oxkDev/Custom-Mechanical-Keyboard/README.md

# Custom-Mechanical-Keyboard
A custom low-profile 75% mechanical keyboard using a WeAct Blackpill v3.1 (STM32F411CEU6).
