oxkDev/Custom-Mechanical-Keyboard/Custom Keyboard Exports/Custom Mechanical Keyboard.csv

Reference | Qty | Value | DNP | Exclude from BOM | Type | Manufacturer | MFG Part # | Footprint | Description
C1,C2,C3,C4,C5,C6,C7,C8,C9,C10,C11,C12 | 12 | 100nF |  |  | SMD | Murata Electronics | GRM3195C2A104JA01D | Capacitor_SMD:C_1206_3216Metric | Multilayer Ceramic Capacitors MLCC - SMD/SMT 0.1 uF 100 VDC 5% 1206 C0G (NP0)
CAPS_LED1 | 1 | SK6812MINI-E |  |  | SMD | Shenzhen Normand Electronic | SK6803MINI-E | LED_SMD:LED_SK6812MINI-E_PLCC4_3.2x2.8mm_P1.5mm_1 | 3.2x2.8x1.78 mm 0.2W Intelligent external control surface mount SMD LED (Facing away from PCB)
J1 | 1 | USB_C_Receptacle_USB2.0_16P | DNP | Excluded from BOM |  |  |  | PCM_marbastlib-various:USB_C_Receptacle_HRO_TYPE-C-31-M-14_(polygon_edge) | USB 2.0-only 16P Type-C Receptacle connector
J2 | 1 | Conn_01x04 | DNP | Excluded from BOM |  |  |  | Connector_PinHeader_2.00mm:PinHeader_1x04_P2.00mm_Vertical | Generic connector, single row, 01x04, script generated (kicad-library-utils/schlib/autogen/connector/)
J3 | 1 | Conn_01x05 |  | Excluded from BOM |  |  |  | Connector_PinHeader_2.00mm:PinHeader_1x05_P2.00mm_Vertical | Generic connector, single row, 01x05, script generated (kicad-library-utils/schlib/autogen/connector/)
J4 | 1 | Conn_01x06 |  | Excluded from BOM |  |  |  | Connector_PinHeader_2.00mm:PinHeader_1x06_P2.00mm_Vertical | Generic connector, single row, 01x06, script generated (kicad-library-utils/schlib/autogen/connector/)
J5 | 1 | Conn_01x07 |  | Excluded from BOM |  |  |  | Connector_PinHeader_2.00mm:PinHeader_1x07_P2.00mm_Vertical | Generic connector, single row, 01x07, script generated (kicad-library-utils/schlib/autogen/connector/)
J6,J7 | 2 | Conn_01x20_Socket |  |  |  |  |  | PCM_marbastlib-various:XUNPU_FPC-05F-20PH20_1x20-1MP_P0.5mm_Horizontal | Generic connectable mounting pin connector, single row, 01x20, script generated (kicad-library-utils/schlib/autogen/connector/)
LED1,LED2,LED3,LED4,LED5,LED6,LED7,LED8,LED9,LED10,LED11,LED12,LED13,LED14,LED15,LED16,LED17,LED18,LED19,LED20,LED21,LED22,LED23,LED24,LED25,LED26,LED27,LED28,LED29,LED30,LED31,LED32,LED33,LED34,LED35,LED36,LED37,LED38,LED39,LED40,LED41,LED42,LED43,LED44,LED45,LED46,LED47,LED48,LED49,LED50,LED51,LED52,LED53,LED54,LED55,LED56,LED57,LED58,LED59,LED60,LED61,LED62,LED63,LED64,LED65,LED66,LED67,LED68,LED69,LED70,LED71,LED72,LED73,LED74,LED75,LED76,LED77,LED78,LED79,LED80,LED81,LED82,LED83,LED84 | 84 | SK6812MINI-E_Rev |  |  | SMD | Shenzhen Normand Electronic | SK6803MINI-E | LED_SMD:LED_SK6812MINI-E_Reversed_PLCC4_3.2x2.8mm_P1.5mm | 3.2x2.8x1.78 mm 0.2W Intelligent external control surface mount SMD LED (Facing into PCB)
R1,R2 | 2 | 5.1k | DNP | Excluded from BOM | SMD | Panasonic | ERJ-8ENF5101V | Resistor_SMD:R_1206_3216Metric_Pad1.30x1.75mm_HandSolder | 5.1 kOhms ±1% 0.25W, 1/4W Chip Resistor 1206 (3216 Metric) Automotive AEC-Q200 Thick Film
R3,R4 | 2 | 100k |  |  | SMD | Panasonic | ERJ-U08D1003V | Resistor_SMD:R_1206_3216Metric_Pad1.30x1.75mm_HandSolder | Thick Film Resistors - SMD 1206 0.5% 100kOhm Anti-Sulfur AEC-Q200
ROT_SW1 | 1 | RotaryEncoder_Switch_MP |  | Excluded from BOM |  |  |  | Rotary_Encoder:RotaryEncoder_Alps_EC12E-Switch_Vertical_H20mm | Rotary encoder, dual channel, incremental quadrate outputs, with switch and MP Pin
SOI8_SLCT1,USB_DM1,USB_DP1,USB_ID1,USB_VBUS1,VBat1 | 6 | TestPoint |  | Excluded from BOM |  |  |  | TestPoint:TestPoint_Pad_D1.0mm | test point
SW1,SW2,SW3,SW4,SW5,SW6,SW7,SW8,SW9,SW10,SW11,SW12,SW13,SW14,SW15,SW16,SW17,SW18,SW19,SW20,SW21,SW22,SW23,SW24,SW25,SW26,SW27,SW28,SW29,SW30,SW31,SW32,SW33,SW34,SW35,SW36,SW37,SW38,SW39,SW40,SW41,SW42,SW43,SW44,SW45,SW46,SW47,SW48,SW49,SW50,SW51,SW52,SW53,SW54,SW55,SW56,SW57,SW58,SW59,SW60,SW61,SW62,SW63,SW64,SW65,SW66,SW67,SW68,SW69,SW70,SW71,SW72,SW73,SW74,SW75,SW76,SW77,SW78,SW79,SW80,SW81,SW82,SW83,SW84 | 84 | SW_SPST |  | Excluded from BOM |  |  |  | Key_Switches_Low_Profile:SW_MX_Kailh_Choc_V1V2_Mill-Max_Hybrid | Key Switch
SW85 | 1 | SW_Slide_DPDT |  |  | Thru-Hole | C&K | JS202011AQN | Button_Switch_THT:SW_CK_JS202011AQN_DPDT_Angled | SWITCH SLIDE DPDT 300MA 6V
U1 | 1 | Blackpill |  | Excluded from BOM |  |  |  | Weact_Blackpill_STM32F411CEU6:STM32F4x1CxU6 WeActStudio | MCU
U2 | 1 | TXS0101DBV |  |  | SMD | Texas Instruments | TXS0101DBV | Package_TO_SOT_SMD:SOT-23-6 | 1-Bit Bidirectional Voltage-Level Shifter for Open-Drain and Push-Pull Application, SOT-23
U3 | 1 | USBLC6-2SC6 |  |  | SMD | STMicroelectronics | USBLC6-2SC6 | Package_TO_SOT_SMD:SOT-23-6 | Very low capacitance ESD protection diode, 2 data-line, SOT-23-6
D1,D3,D5,D7,D9,D11,D13,D15,D17,D19,D21,D23,D25,D27,D29,D32,D34,D36,D38,D40,D42,D44,D45,D47,D49,D51,D53,D55,D57,D61,D63,D65,D67,D69,D71,D72,D73,D75,D77,D80,D81,D83,ROT_D1 | 43 | D |  |  | SMD | Diodes Incorporated | 1N4148W-F | Keyboard_Parts_Footprint:D_SOD123 | Small Signal Switching Diodes 400mW 100Vrrm 4ns
D2,D4,D6,D8,D10,D12,D14,D16,D18,D20,D22,D24,D26,D28,D30,D31,D33,D35,D37,D39,D41,D43,D46,D48,D50,D52,D54,D56,D58,D59,D60,D62,D64,D66,D68,D70,D74,D76,D78,D79,D82,D84 | 42 | D_Rev |  |  | SMD | Diodes Incorporated | 1N4148W-F | Keyboard_Parts_Footprint:D_SOD123_Rev | Small Signal Switching Diodes 400mW 100Vrrm 4ns
