oxkDev/Custom-Mechanical-Keyboard/Custom Keyboard Kicad/Custom Mechanical Keyboard.kicad_pcb

## KiCad design Custom Keyboard Kicad/Custom Mechanical Keyboard.kicad_pcb (2025-11-11)

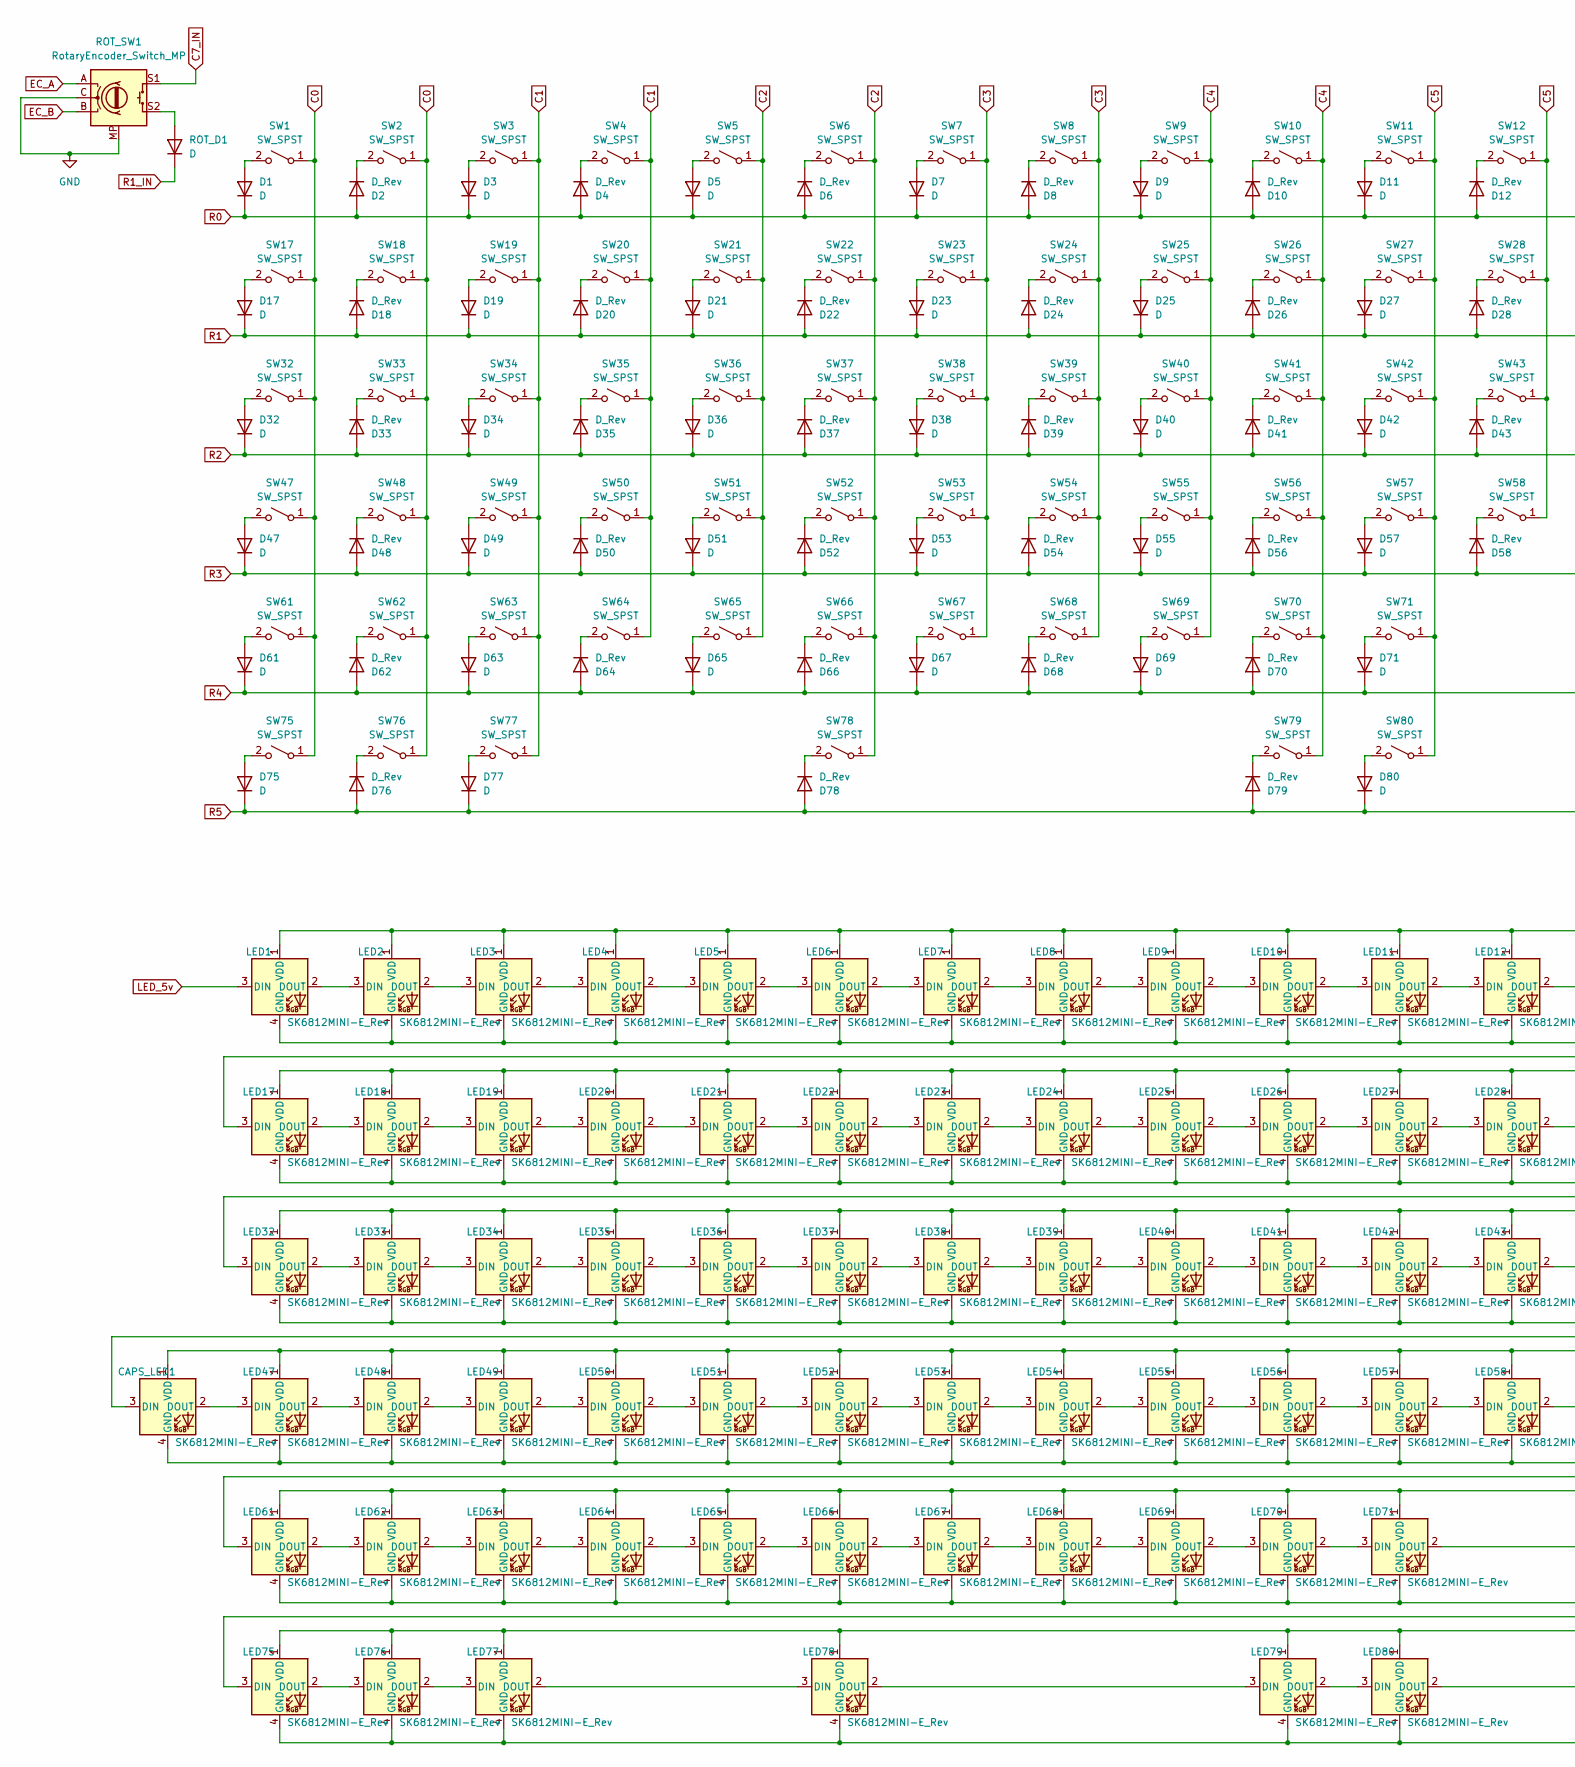
[picture p1: schematic Custom Mechanical Keyboard.kicad_sch, part in row 1, column 1]

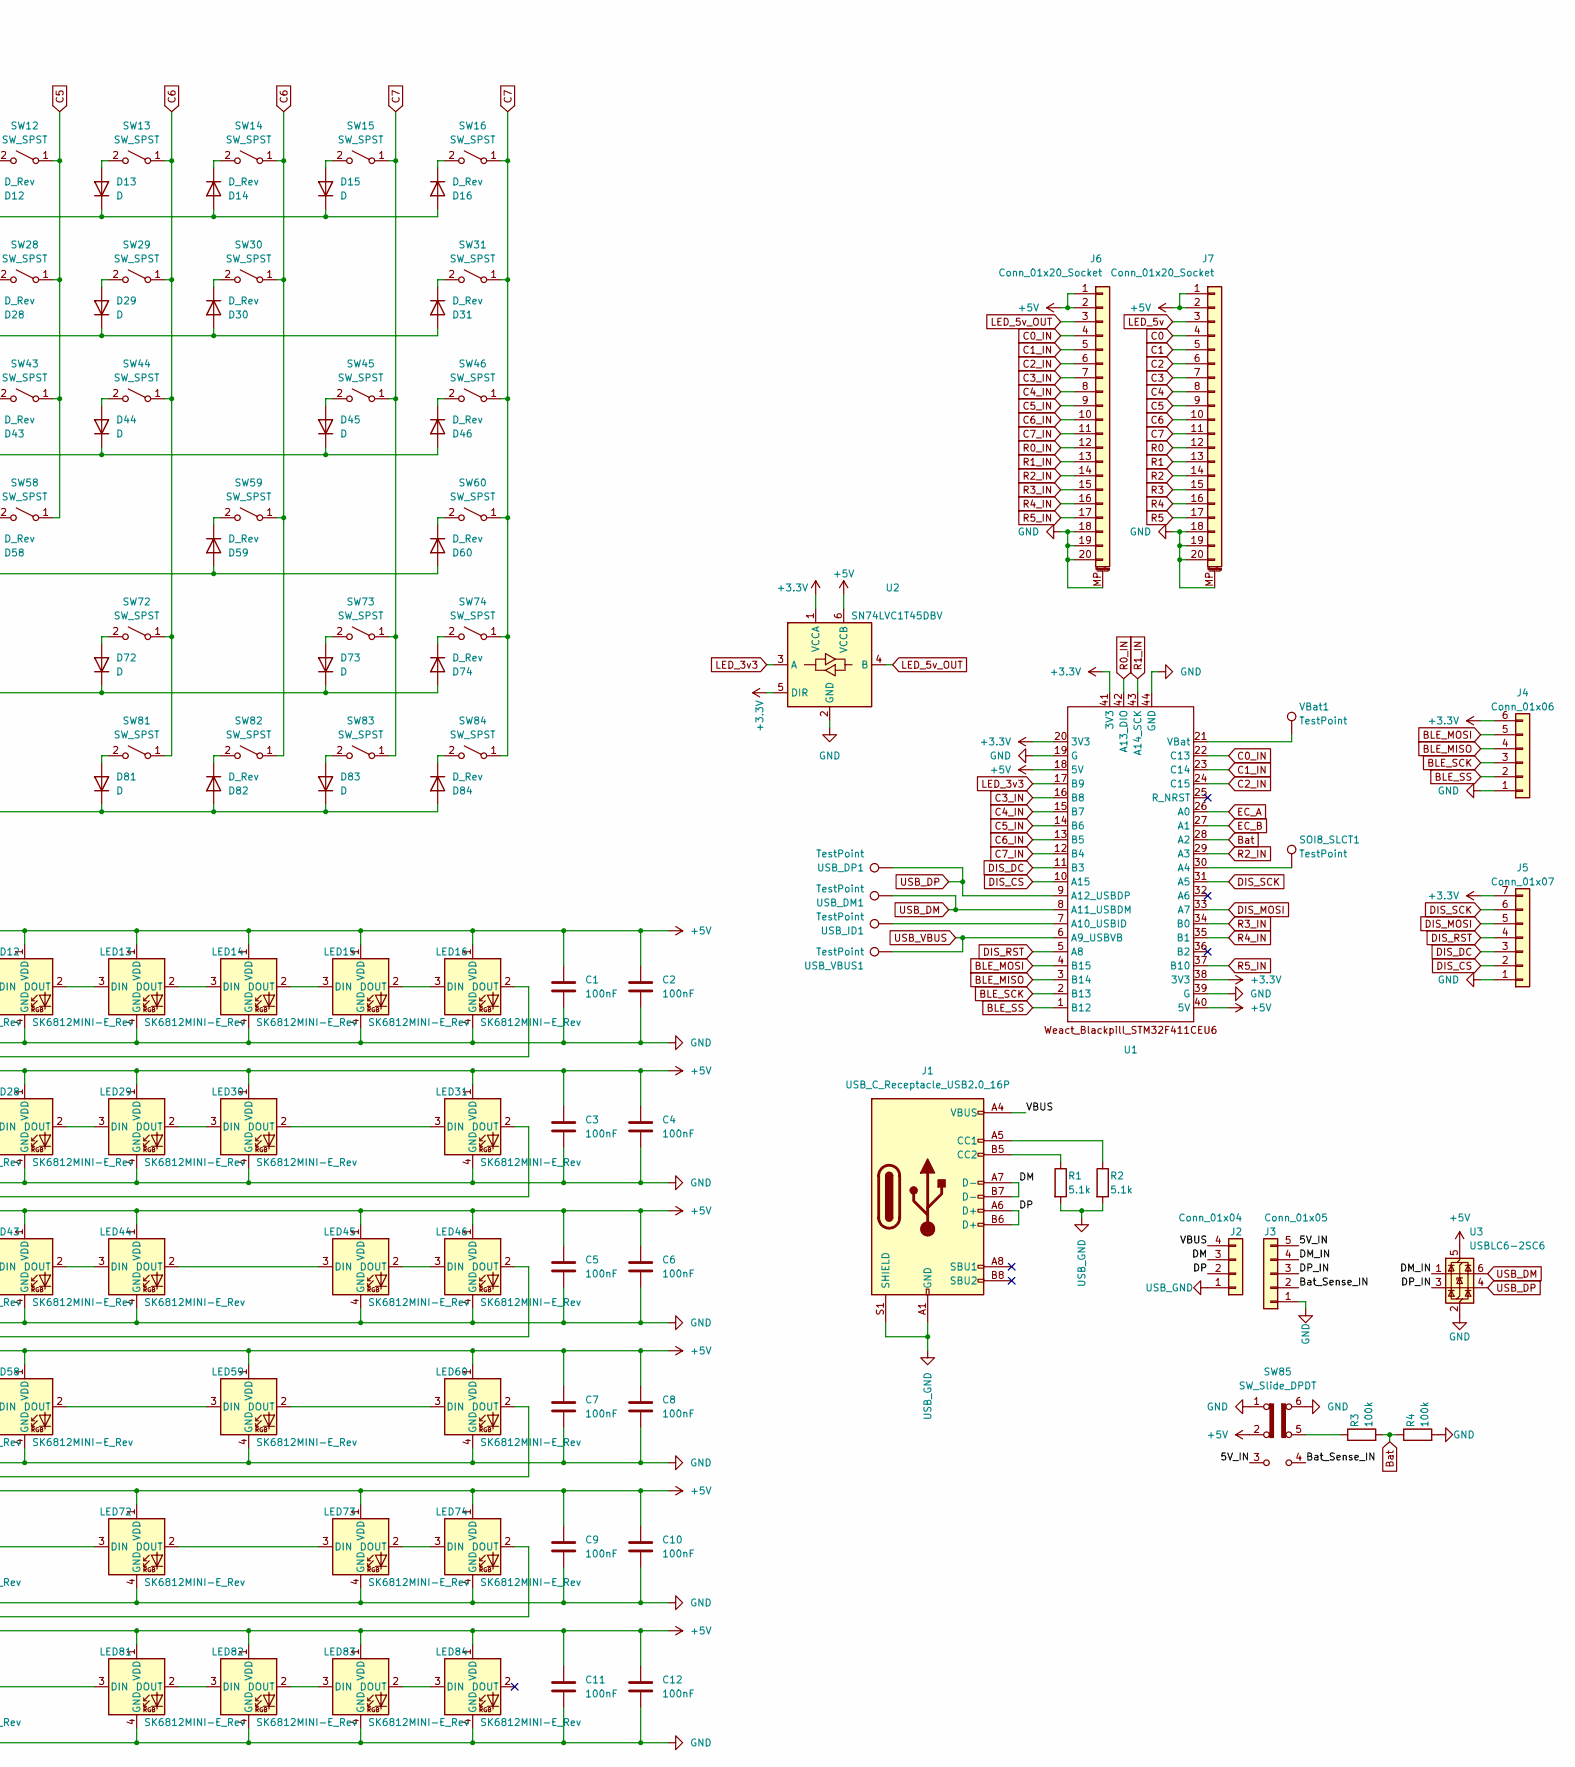
[picture p2: schematic Custom Mechanical Keyboard.kicad_sch, part in row 1, column 2]

Parts:
C1, C2, C3, C4, C5, C6, C7, C8, C9, C10, C11, C12: 100nF; C_1206_3216Metric; MFG Part # GRM3195C2A104JA01D
CAPS_LED1: SK6812MINI-E_Rev; LED_SK6812MINI-E_Reversed_PLCC4_3.2x2.8mm_P1.5mm; MFG Part # SK6803MINI-E
D1, D3, D5, D7, D9, D11, D13, D15, D17, D19, D21, D23, D25, D27, D29, D32, D34, D36, D38, D40, D42, D44, D45, D47, D49, D51, D53, D55, D57, D61, D63, D65, D67, D69, D71, D72, D73, D75, D77, D80, D81, D83: D; D_SOD123; MFG Part # 1N4148W-F
D2, D4, D6, D8, D10, D12, D14, D16, D18, D20, D22, D24, D26, D28, D30, D31, D33, D35, D37, D39, D41, D43, D46, D48, D50, D52, D54, D56, D58, D59, D60, D62, D64, D66, D68, D70, D74, D76, D78, D79, D82, D84: D_Rev; D_SOD123_Rev; MFG Part # 1N4148W-F
J1: USB_C_Receptacle_USB2.0_16P; USB_C_Receptacle_HRO_TYPE-C-31-M-12; MFG Part # TYPE-C-31-M-14
J2: Conn_01x04; PinHeader_1x04_P2.00mm_Vertical
J3: Conn_01x05; PinHeader_1x05_P2.00mm_Vertical
J4: Conn_01x06; PinHeader_1x06_P2.00mm_Vertical
J5: Conn_01x07; PinHeader_1x07_P2.00mm_Vertical
J6, J7: Conn_01x20_Socket; XUNPU_FPC-05F-20PH20_1x20-1MP_P0.5mm_Horizontal; MFG Part # FPC-05F-20PH20
LED1, LED2, LED3, LED4, LED5, LED6, LED7, LED8, LED9, LED10, LED11, LED12, LED13, LED14, LED15, LED16, LED17, LED18, LED19, LED20, LED21, LED22, LED23, LED24, LED25, LED26, LED27, LED28, LED29, LED30, LED31, LED32, LED33, LED34, LED35, LED36, LED37, LED38, LED39, LED40, LED41, LED42, LED43, LED44, LED45, LED46, LED47, LED48, LED49, LED50, LED51, LED52, LED53, LED54, LED55, LED56, LED57, LED58, LED59, LED60, LED61, LED62, LED63, LED64, LED65, LED66, LED67, LED68, LED69, LED70, LED71, LED72, LED73, LED74, LED75, LED76, LED77, LED78, LED79, LED80, LED81, LED82, LED83, LED84: SK6812MINI-E_Rev; LED_SK6812MINI-E_Reversed_PLCC4_3.2x2.8mm_P1.5mm; MFG Part # SK6803MINI-E
R1, R2: 5.1k; R_1206_3216Metric_Pad1.30x1.75mm_HandSolder; MFG Part # ERJ-8ENF5101V
R3, R4: 100k; R_1206_3216Metric_Pad1.30x1.75mm_HandSolder; MFG Part # ERJ-U08D1003V
ROT_D1: D; D_SOD123; MFG Part # 1N4148W-F
ROT_SW1: RotaryEncoder_Switch_MP; RotaryEncoder_Alps_EC12E-Switch_Vertical_H20mm
SOI8_SLCT1: TestPoint; TestPoint_Pad_D1.0mm
SW1, SW2, SW3, SW4, SW5, SW6, SW7, SW8, SW9, SW10, SW11, SW12, SW13, SW14, SW15, SW16, SW17, SW18, SW19, SW20, SW21, SW22, SW23, SW24, SW25, SW26, SW27, SW28, SW29, SW30, SW31, SW32, SW33, SW34, SW35, SW36, SW37, SW38, SW39, SW40, SW41, SW42, SW43, SW44, SW45, SW46, SW47, SW48, SW49, SW50, SW51, SW52, SW53, SW54, SW55, SW56, SW57, SW58, SW59, SW60, SW61, SW62, SW63, SW64, SW65, SW66, SW67, SW68, SW69, SW70, SW71, SW72, SW73, SW74, SW75, SW76, SW77, SW78, SW79, SW80, SW81, SW82, SW83, SW84: SW_SPST; SW_MX_Kailh_Choc_V1V2_Mill-Max_Hybrid
SW85: SW_Slide_DPDT; SW_CK_JS202011AQN_DPDT_Angled; MFG Part # JS202011AQN
U1: Blackpill; STM32F4x1CxU6 WeActStudio
U2: SN74LVC1T45DBV; SOT-23-6; MFG Part # SN74LVC1T45DBV\
U3: USBLC6-2SC6; SOT-23-6; MFG Part # USBLC6-2SC6
USB_DM1: TestPoint; TestPoint_Pad_D1.0mm
USB_DP1: TestPoint; TestPoint_Pad_D1.0mm
USB_ID1: TestPoint; TestPoint_Pad_D1.0mm
USB_VBUS1: TestPoint; TestPoint_Pad_D1.0mm
VBat1: TestPoint; TestPoint_Pad_D1.0mm

Connections:
+3.3V: J4.6, J5.7, U1.20 (3V3), U1.38 (3V3), U1.41 (3V3), U2.1 (VCCA), U2.5 (DIR)
+5V: C1.1, C2.1, C3.1, C4.1, C5.1, C6.1, C7.1, C8.1, C9.1, C10.1, C11.1, C12.1, CAPS_LED1.1 (VDD), J6.1, J6.2, J7.1, J7.2, LED1.1 (VDD), LED2.1 (VDD), LED3.1 (VDD), LED4.1 (VDD), LED5.1 (VDD), LED6.1 (VDD), LED7.1 (VDD), LED8.1 (VDD), LED9.1 (VDD), LED10.1 (VDD), LED11.1 (VDD), LED12.1 (VDD), LED13.1 (VDD), LED14.1 (VDD), LED15.1 (VDD), LED16.1 (VDD), LED17.1 (VDD), LED18.1 (VDD), LED19.1 (VDD), LED20.1 (VDD), LED21.1 (VDD), LED22.1 (VDD), LED23.1 (VDD), LED24.1 (VDD), LED25.1 (VDD), LED26.1 (VDD), LED27.1 (VDD), LED28.1 (VDD), LED29.1 (VDD), LED30.1 (VDD), LED31.1 (VDD), LED32.1 (VDD), LED33.1 (VDD), LED34.1 (VDD), LED35.1 (VDD), LED36.1 (VDD), LED37.1 (VDD), LED38.1 (VDD), LED39.1 (VDD), LED40.1 (VDD), LED41.1 (VDD), LED42.1 (VDD), LED43.1 (VDD), LED44.1 (VDD), LED45.1 (VDD), LED46.1 (VDD), LED47.1 (VDD), LED48.1 (VDD), LED49.1 (VDD), LED50.1 (VDD), LED51.1 (VDD), LED52.1 (VDD), LED53.1 (VDD), LED54.1 (VDD), LED55.1 (VDD), LED56.1 (VDD), LED57.1 (VDD), LED58.1 (VDD), LED59.1 (VDD), LED60.1 (VDD), LED61.1 (VDD), LED62.1 (VDD), LED63.1 (VDD), LED64.1 (VDD), LED65.1 (VDD), LED66.1 (VDD), LED67.1 (VDD), LED68.1 (VDD), LED69.1 (VDD), LED70.1 (VDD), LED71.1 (VDD), LED72.1 (VDD), LED73.1 (VDD), LED74.1 (VDD), LED75.1 (VDD), LED76.1 (VDD), LED77.1 (VDD), LED78.1 (VDD), LED79.1 (VDD), LED80.1 (VDD), LED81.1 (VDD), LED82.1 (VDD), LED83.1 (VDD), LED84.1 (VDD), SW85.2 (B), U1.18 (5V), U1.40 (5V), U2.6 (VCCB), U3.5 (VBUS)
/5V_IN: J3.5, SW85.3 (C)
/Bat_Sense_IN: J3.2, SW85.4 (A)
/DM: J1.A7 (D-), J1.B7 (D-), J2.3
/DM_IN: J3.4, U3.1 (I/O1)
/DP: J1.A6 (D+), J1.B6 (D+), J2.2
/DP_IN: J3.3, U3.3 (I/O2)
/VBUS: J1.A4 (VBUS), J1.A9 (VBUS), J1.B4 (VBUS), J1.B9 (VBUS), J2.4
BLE_MISO: J4.4, U1.3 (B14)
BLE_MOSI: J4.5, U1.4 (B15)
BLE_SCK: J4.3, U1.2 (B13)
BLE_SS: J4.2, U1.1 (B12)
Bat: R3.2, R4.1, U1.28 (A2)
C0: J7.4, SW1.1 (A), SW2.1 (A), SW17.1 (A), SW18.1 (A), SW32.1 (A), SW33.1 (A), SW47.1 (A), SW48.1 (A), SW61.1 (A), SW62.1 (A), SW75.1 (A), SW76.1 (A)
C0_IN: J6.4, U1.22 (C13)
C1: J7.5, SW3.1 (A), SW4.1 (A), SW19.1 (A), SW20.1 (A), SW34.1 (A), SW35.1 (A), SW49.1 (A), SW50.1 (A), SW63.1 (A), SW64.1 (A), SW77.1 (A)
C1_IN: J6.5, U1.23 (C14)
C2: J7.6, SW5.1 (A), SW6.1 (A), SW21.1 (A), SW22.1 (A), SW36.1 (A), SW37.1 (A), SW51.1 (A), SW52.1 (A), SW65.1 (A), SW66.1 (A), SW78.1 (A)
C2_IN: J6.6, U1.24 (C15)
C3: J7.7, SW7.1 (A), SW8.1 (A), SW23.1 (A), SW24.1 (A), SW38.1 (A), SW39.1 (A), SW53.1 (A), SW54.1 (A), SW67.1 (A), SW68.1 (A)
C3_IN: J6.7, U1.16 (B8)
C4: J7.8, SW9.1 (A), SW10.1 (A), SW25.1 (A), SW26.1 (A), SW40.1 (A), SW41.1 (A), SW55.1 (A), SW56.1 (A), SW69.1 (A), SW70.1 (A), SW79.1 (A)
C4_IN: J6.8, U1.15 (B7)
C5: J7.9, SW11.1 (A), SW12.1 (A), SW27.1 (A), SW28.1 (A), SW42.1 (A), SW43.1 (A), SW57.1 (A), SW58.1 (A), SW71.1 (A), SW80.1 (A)
C5_IN: J6.9, U1.14 (B6)
C6: J7.10, SW13.1 (A), SW14.1 (A), SW29.1 (A), SW30.1 (A), SW44.1 (A), SW59.1 (A), SW72.1 (A), SW81.1 (A), SW82.1 (A)
C6_IN: J6.10, U1.13 (B5)
C7: J7.11, SW15.1 (A), SW16.1 (A), SW31.1 (A), SW45.1 (A), SW46.1 (A), SW60.1 (A), SW73.1 (A), SW74.1 (A), SW83.1 (A), SW84.1 (A)
C7_IN: J6.11, ROT_SW1.S1, U1.12 (B4)
DIS_CS: J5.2, U1.10 (A15)
DIS_DC: J5.3, U1.11 (B3)
DIS_MOSI: J5.5, U1.33 (A7)
DIS_RST: J5.4, U1.5 (A8)
DIS_SCK: J5.6, U1.31 (A5)
EC_A: ROT_SW1.A, U1.26 (A0)
EC_B: ROT_SW1.B, U1.27 (A1)
GND: C1.2, C2.2, C3.2, C4.2, C5.2, C6.2, C7.2, C8.2, C9.2, C10.2, C11.2, C12.2, CAPS_LED1.4 (GND), J3.1, J4.1, J5.1, J6.18, J6.19, J6.20, J6.MP (MountPin), J7.18, J7.19, J7.20, J7.MP (MountPin), LED1.4 (GND), LED2.4 (GND), LED3.4 (GND), LED4.4 (GND), LED5.4 (GND), LED6.4 (GND), LED7.4 (GND), LED8.4 (GND), LED9.4 (GND), LED10.4 (GND), LED11.4 (GND), LED12.4 (GND), LED13.4 (GND), LED14.4 (GND), LED15.4 (GND), LED16.4 (GND), LED17.4 (GND), LED18.4 (GND), LED19.4 (GND), LED20.4 (GND), LED21.4 (GND), LED22.4 (GND), LED23.4 (GND), LED24.4 (GND), LED25.4 (GND), LED26.4 (GND), LED27.4 (GND), LED28.4 (GND), LED29.4 (GND), LED30.4 (GND), LED31.4 (GND), LED32.4 (GND), LED33.4 (GND), LED34.4 (GND), LED35.4 (GND), LED36.4 (GND), LED37.4 (GND), LED38.4 (GND), LED39.4 (GND), LED40.4 (GND), LED41.4 (GND), LED42.4 (GND), LED43.4 (GND), LED44.4 (GND), LED45.4 (GND), LED46.4 (GND), LED47.4 (GND), LED48.4 (GND), LED49.4 (GND), LED50.4 (GND), LED51.4 (GND), LED52.4 (GND), LED53.4 (GND), LED54.4 (GND), LED55.4 (GND), LED56.4 (GND), LED57.4 (GND), LED58.4 (GND), LED59.4 (GND), LED60.4 (GND), LED61.4 (GND), LED62.4 (GND), LED63.4 (GND), LED64.4 (GND), LED65.4 (GND), LED66.4 (GND), LED67.4 (GND), LED68.4 (GND), LED69.4 (GND), LED70.4 (GND), LED71.4 (GND), LED72.4 (GND), LED73.4 (GND), LED74.4 (GND), LED75.4 (GND), LED76.4 (GND), LED77.4 (GND), LED78.4 (GND), LED79.4 (GND), LED80.4 (GND), LED81.4 (GND), LED82.4 (GND), LED83.4 (GND), LED84.4 (GND), R4.2, ROT_SW1.C, ROT_SW1.MP, SW85.1 (A), SW85.6 (C), U1.19 (G), U1.39 (G), U1.44 (GND), U2.2 (GND), U3.2 (GND)
LED_3v3: U1.17 (B9), U2.3 (A)
LED_5v: J7.3, LED1.3 (DIN)
LED_5v_OUT: J6.3, U2.4 (B)
unnamed: CAPS_LED1.3 (DIN), LED46.2 (DOUT)
unnamed: CAPS_LED1.2 (DOUT), LED47.3 (DIN)
unnamed: D1.2 (A), SW1.2 (B)
unnamed: D2.1 (K), SW2.2 (B)
unnamed: D3.2 (A), SW3.2 (B)
unnamed: D4.1 (K), SW4.2 (B)
unnamed: D5.2 (A), SW5.2 (B)
unnamed: D6.1 (K), SW6.2 (B)
unnamed: D7.2 (A), SW7.2 (B)
unnamed: D8.1 (K), SW8.2 (B)
unnamed: D9.2 (A), SW9.2 (B)
unnamed: D10.1 (K), SW10.2 (B)
unnamed: D11.2 (A), SW11.2 (B)
unnamed: D12.1 (K), SW12.2 (B)
unnamed: D13.2 (A), SW13.2 (B)
unnamed: D14.1 (K), SW14.2 (B)
unnamed: D15.2 (A), SW15.2 (B)
unnamed: D16.1 (K), SW16.2 (B)
unnamed: D17.2 (A), SW17.2 (B)
unnamed: D18.1 (K), SW18.2 (B)
unnamed: D19.2 (A), SW19.2 (B)
unnamed: D20.1 (K), SW20.2 (B)
unnamed: D21.2 (A), SW21.2 (B)
unnamed: D22.1 (K), SW22.2 (B)
unnamed: D23.2 (A), SW23.2 (B)
unnamed: D24.1 (K), SW24.2 (B)
unnamed: D25.2 (A), SW25.2 (B)
unnamed: D26.1 (K), SW26.2 (B)
unnamed: D27.2 (A), SW27.2 (B)
unnamed: D28.1 (K), SW28.2 (B)
unnamed: D29.2 (A), SW29.2 (B)
unnamed: D30.1 (K), SW30.2 (B)
unnamed: D31.1 (K), SW31.2 (B)
unnamed: D32.2 (A), SW32.2 (B)
unnamed: D33.1 (K), SW33.2 (B)
unnamed: D34.2 (A), SW34.2 (B)
unnamed: D35.1 (K), SW35.2 (B)
unnamed: D36.2 (A), SW36.2 (B)
unnamed: D37.1 (K), SW37.2 (B)
unnamed: D38.2 (A), SW38.2 (B)
unnamed: D39.1 (K), SW39.2 (B)
unnamed: D40.2 (A), SW40.2 (B)
unnamed: D41.1 (K), SW41.2 (B)
unnamed: D42.2 (A), SW42.2 (B)
unnamed: D43.1 (K), SW43.2 (B)
unnamed: D44.2 (A), SW44.2 (B)
unnamed: D45.2 (A), SW45.2 (B)
unnamed: D46.1 (K), SW46.2 (B)
unnamed: D47.2 (A), SW47.2 (B)
unnamed: D48.1 (K), SW48.2 (B)
unnamed: D49.2 (A), SW49.2 (B)
unnamed: D50.1 (K), SW50.2 (B)
unnamed: D51.2 (A), SW51.2 (B)
unnamed: D52.1 (K), SW52.2 (B)
unnamed: D53.2 (A), SW53.2 (B)
unnamed: D54.1 (K), SW54.2 (B)
unnamed: D55.2 (A), SW55.2 (B)
unnamed: D56.1 (K), SW56.2 (B)
unnamed: D57.2 (A), SW57.2 (B)
unnamed: D58.1 (K), SW58.2 (B)
unnamed: D59.1 (K), SW59.2 (B)
unnamed: D60.1 (K), SW60.2 (B)
unnamed: D61.2 (A), SW61.2 (B)
unnamed: D62.1 (K), SW62.2 (B)
unnamed: D63.2 (A), SW63.2 (B)
unnamed: D64.1 (K), SW64.2 (B)
unnamed: D65.2 (A), SW65.2 (B)
unnamed: D66.1 (K), SW66.2 (B)
unnamed: D67.2 (A), SW67.2 (B)
unnamed: D68.1 (K), SW68.2 (B)
unnamed: D69.2 (A), SW69.2 (B)
unnamed: D70.1 (K), SW70.2 (B)
unnamed: D71.2 (A), SW71.2 (B)
unnamed: D72.2 (A), SW72.2 (B)
unnamed: D73.2 (A), SW73.2 (B)
unnamed: D74.1 (K), SW74.2 (B)
unnamed: D75.2 (A), SW75.2 (B)
unnamed: D76.1 (K), SW76.2 (B)
unnamed: D77.2 (A), SW77.2 (B)
unnamed: D78.1 (K), SW78.2 (B)
unnamed: D79.1 (K), SW79.2 (B)
unnamed: D80.2 (A), SW80.2 (B)
unnamed: D81.2 (A), SW81.2 (B)
unnamed: D82.1 (K), SW82.2 (B)
unnamed: D83.2 (A), SW83.2 (B)
unnamed: D84.1 (K), SW84.2 (B)
unnamed: J1.A5 (CC1), R2.1
unnamed: J1.B5 (CC2), R1.1
unnamed: LED1.2 (DOUT), LED2.3 (DIN)
unnamed: LED2.2 (DOUT), LED3.3 (DIN)
unnamed: LED3.2 (DOUT), LED4.3 (DIN)
unnamed: LED4.2 (DOUT), LED5.3 (DIN)
unnamed: LED5.2 (DOUT), LED6.3 (DIN)
unnamed: LED6.2 (DOUT), LED7.3 (DIN)
unnamed: LED7.2 (DOUT), LED8.3 (DIN)
unnamed: LED8.2 (DOUT), LED9.3 (DIN)
unnamed: LED9.2 (DOUT), LED10.3 (DIN)
unnamed: LED10.2 (DOUT), LED11.3 (DIN)
unnamed: LED11.2 (DOUT), LED12.3 (DIN)
unnamed: LED12.2 (DOUT), LED13.3 (DIN)
unnamed: LED13.2 (DOUT), LED14.3 (DIN)
unnamed: LED14.2 (DOUT), LED15.3 (DIN)
unnamed: LED15.2 (DOUT), LED16.3 (DIN)
unnamed: LED16.2 (DOUT), LED17.3 (DIN)
unnamed: LED17.2 (DOUT), LED18.3 (DIN)
unnamed: LED18.2 (DOUT), LED19.3 (DIN)
unnamed: LED19.2 (DOUT), LED20.3 (DIN)
unnamed: LED20.2 (DOUT), LED21.3 (DIN)
unnamed: LED21.2 (DOUT), LED22.3 (DIN)
unnamed: LED22.2 (DOUT), LED23.3 (DIN)
unnamed: LED23.2 (DOUT), LED24.3 (DIN)
unnamed: LED24.2 (DOUT), LED25.3 (DIN)
unnamed: LED25.2 (DOUT), LED26.3 (DIN)
unnamed: LED26.2 (DOUT), LED27.3 (DIN)
unnamed: LED27.2 (DOUT), LED28.3 (DIN)
unnamed: LED28.2 (DOUT), LED29.3 (DIN)
unnamed: LED29.2 (DOUT), LED30.3 (DIN)
unnamed: LED30.2 (DOUT), LED31.3 (DIN)
unnamed: LED31.2 (DOUT), LED32.3 (DIN)
unnamed: LED32.2 (DOUT), LED33.3 (DIN)
unnamed: LED33.2 (DOUT), LED34.3 (DIN)
unnamed: LED34.2 (DOUT), LED35.3 (DIN)
unnamed: LED35.2 (DOUT), LED36.3 (DIN)
unnamed: LED36.2 (DOUT), LED37.3 (DIN)
unnamed: LED37.2 (DOUT), LED38.3 (DIN)
unnamed: LED38.2 (DOUT), LED39.3 (DIN)
unnamed: LED39.2 (DOUT), LED40.3 (DIN)
unnamed: LED40.2 (DOUT), LED41.3 (DIN)
unnamed: LED41.2 (DOUT), LED42.3 (DIN)
unnamed: LED42.2 (DOUT), LED43.3 (DIN)
unnamed: LED43.2 (DOUT), LED44.3 (DIN)
unnamed: LED44.2 (DOUT), LED45.3 (DIN)
unnamed: LED45.2 (DOUT), LED46.3 (DIN)
unnamed: LED47.2 (DOUT), LED48.3 (DIN)
unnamed: LED48.2 (DOUT), LED49.3 (DIN)
unnamed: LED49.2 (DOUT), LED50.3 (DIN)
unnamed: LED50.2 (DOUT), LED51.3 (DIN)
unnamed: LED51.2 (DOUT), LED52.3 (DIN)
unnamed: LED52.2 (DOUT), LED53.3 (DIN)
unnamed: LED53.2 (DOUT), LED54.3 (DIN)
unnamed: LED54.2 (DOUT), LED55.3 (DIN)
unnamed: LED55.2 (DOUT), LED56.3 (DIN)
unnamed: LED56.2 (DOUT), LED57.3 (DIN)
unnamed: LED57.2 (DOUT), LED58.3 (DIN)
unnamed: LED58.2 (DOUT), LED59.3 (DIN)
unnamed: LED59.2 (DOUT), LED60.3 (DIN)
unnamed: LED60.2 (DOUT), LED61.3 (DIN)
unnamed: LED61.2 (DOUT), LED62.3 (DIN)
unnamed: LED62.2 (DOUT), LED63.3 (DIN)
unnamed: LED63.2 (DOUT), LED64.3 (DIN)
unnamed: LED64.2 (DOUT), LED65.3 (DIN)
unnamed: LED65.2 (DOUT), LED66.3 (DIN)
unnamed: LED66.2 (DOUT), LED67.3 (DIN)
unnamed: LED67.2 (DOUT), LED68.3 (DIN)
unnamed: LED68.2 (DOUT), LED69.3 (DIN)
unnamed: LED69.2 (DOUT), LED70.3 (DIN)
unnamed: LED70.2 (DOUT), LED71.3 (DIN)
unnamed: LED71.2 (DOUT), LED72.3 (DIN)
unnamed: LED72.2 (DOUT), LED73.3 (DIN)
unnamed: LED73.2 (DOUT), LED74.3 (DIN)
unnamed: LED74.2 (DOUT), LED75.3 (DIN)
unnamed: LED75.2 (DOUT), LED76.3 (DIN)
unnamed: LED76.2 (DOUT), LED77.3 (DIN)
unnamed: LED77.2 (DOUT), LED78.3 (DIN)
unnamed: LED78.2 (DOUT), LED79.3 (DIN)
unnamed: LED79.2 (DOUT), LED80.3 (DIN)
unnamed: LED80.2 (DOUT), LED81.3 (DIN)
unnamed: LED81.2 (DOUT), LED82.3 (DIN)
unnamed: LED82.2 (DOUT), LED83.3 (DIN)
unnamed: LED83.2 (DOUT), LED84.3 (DIN)
unnamed: R3.1, SW85.5 (B)
unnamed: ROT_D1.2 (A), ROT_SW1.S2
unnamed: SOI8_SLCT1.1, U1.30 (A4)
unnamed: U1.7 (A10_USBID), USB_ID1.1
unnamed: U1.21 (VBat), VBat1.1
R0: D1.1 (K), D2.2 (A), D3.1 (K), D4.2 (A), D5.1 (K), D6.2 (A), D7.1 (K), D8.2 (A), D9.1 (K), D10.2 (A), D11.1 (K), D12.2 (A), D13.1 (K), D14.2 (A), D15.1 (K), D16.2 (A), J7.12
R0_IN: J6.12, U1.42 (A13_DIO)
R1: D17.1 (K), D18.2 (A), D19.1 (K), D20.2 (A), D21.1 (K), D22.2 (A), D23.1 (K), D24.2 (A), D25.1 (K), D26.2 (A), D27.1 (K), D28.2 (A), D29.1 (K), D30.2 (A), D31.2 (A), J7.13
R1_IN: J6.13, ROT_D1.1 (K), U1.43 (A14_SCK)
R2: D32.1 (K), D33.2 (A), D34.1 (K), D35.2 (A), D36.1 (K), D37.2 (A), D38.1 (K), D39.2 (A), D40.1 (K), D41.2 (A), D42.1 (K), D43.2 (A), D44.1 (K), D45.1 (K), D46.2 (A), J7.14
R2_IN: J6.14, U1.29 (A3)
R3: D47.1 (K), D48.2 (A), D49.1 (K), D50.2 (A), D51.1 (K), D52.2 (A), D53.1 (K), D54.2 (A), D55.1 (K), D56.2 (A), D57.1 (K), D58.2 (A), D59.2 (A), D60.2 (A), J7.15
R3_IN: J6.15, U1.34 (B0)
R4: D61.1 (K), D62.2 (A), D63.1 (K), D64.2 (A), D65.1 (K), D66.2 (A), D67.1 (K), D68.2 (A), D69.1 (K), D70.2 (A), D71.1 (K), D72.1 (K), D73.1 (K), D74.2 (A), J7.16
R4_IN: J6.16, U1.35 (B1)
R5: D75.1 (K), D76.2 (A), D77.1 (K), D78.2 (A), D79.2 (A), D80.1 (K), D81.1 (K), D82.2 (A), D83.1 (K), D84.2 (A), J7.17
R5_IN: J6.17, U1.37 (B10)
USB_DM: U1.8 (A11_USBDM), U3.6 (I/O1), USB_DM1.1
USB_DP: U1.9 (A12_USBDP), U3.4 (I/O2), USB_DP1.1
USB_GND: J1.A1 (GND), J1.A12 (GND), J1.B1 (GND), J1.B12 (GND), J1.S1 (SHIELD), J2.1, R1.2, R2.2
USB_VBUS: U1.6 (A9_USBVB), USB_VBUS1.1

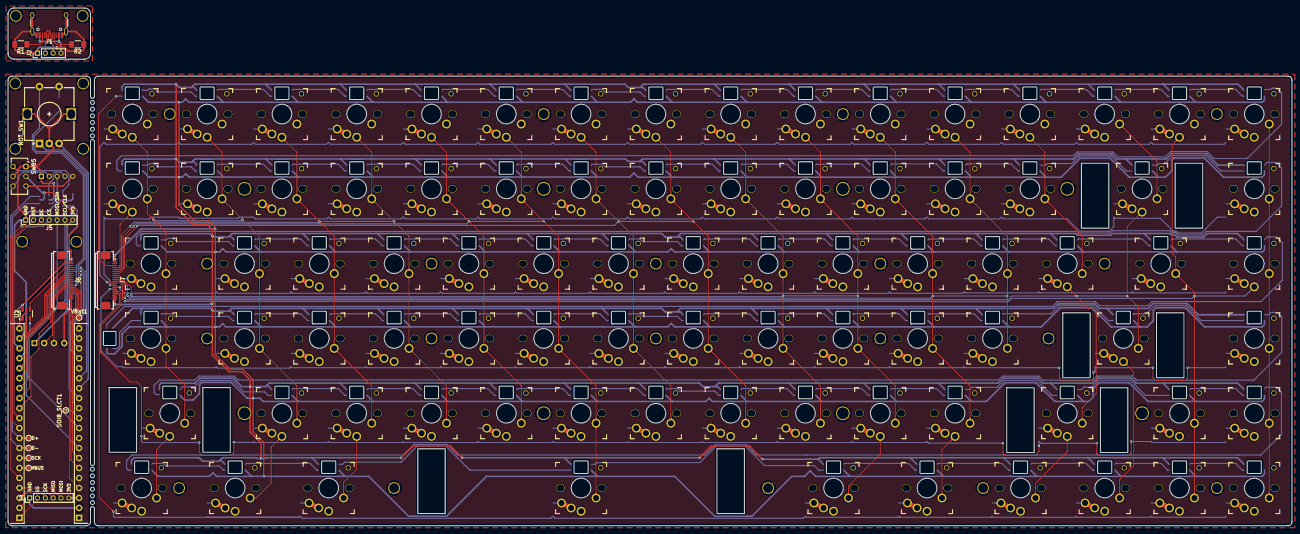
[picture p3: board Custom Mechanical Keyboard.kicad_pcb from above]

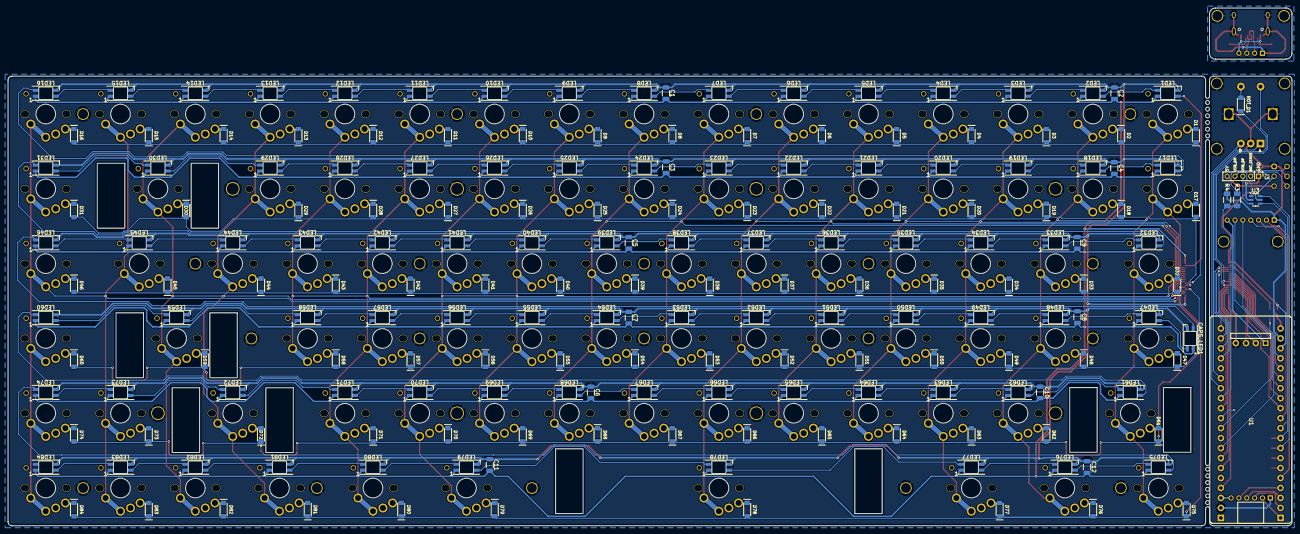
[picture p4: board Custom Mechanical Keyboard.kicad_pcb from below]

Board: 2 copper layers, 327.0 x 114.5 mm, 288 parts (187 on the bottom side), 232 nets.
