oxkDev/Custom-Mechanical-Keyboard/(commit log)

2025-09-28 update files
    [Custom Mechanical Keyboard.kicad_pcb, Custom Mechanical Keyboard.kicad_sch]
2025-09-30 Changed MCU position, swapped screw-in stab mounts for stab cutouts for gateron lp stabilizers
    [Custom Mechanical Keyboard.kicad_pcb, Custom Mechanical Keyboard.kicad_sch]
2025-10-03 Updated wiring, board size, and added rotary encoder and usbc recepticle with esd protection as separate board
    [Custom Mechanical Keyboard.kicad_sch]
2025-10-05 Fixed matrix LED wiring, shifted LED 0.2mm closer to switch. Changed capslock LED to addressable LED connected to matrix LED array.
    [Custom Mechanical Keyboard.kicad_pcb, Custom Mechanical Keyboard.kicad_sch]
2025-10-07 Added custom layout json
    [Custom Mechanical Keyboard.kicad_pcb, Custom Mechanical Keyboard.kicad_sch]
2025-10-15 Added all ports: USB, display (SPI), BLE (SPI). Fixed all main errors in DRC. Added power switch (linked to power input for board).
    [Custom Mechanical Keyboard-B_Cu.gbr, Custom Mechanical Keyboard-B_Mask.gbr, Custom Mechanical Keyboard-B_Paste.gbr, Custom Mechanical Keyboard-B_Silkscreen.gbr, Custom Mechanical Keyboard-Edge_Cuts.gbr, Custom Mechanical Keyboard-F_Cu.gbr, Custom Mechanical Keyboard-F_Mask.gbr, Custom Mechanical Keyboard-F_Paste.gbr]
2025-10-16 Commit before export
    [Custom Mechanical Keyboard-B_Cu.gbr, Custom Mechanical Keyboard-B_Mask.gbr, Custom Mechanical Keyboard-B_Paste.gbr, Custom Mechanical Keyboard-B_Silkscreen.gbr, Custom Mechanical Keyboard-Edge_Cuts.gbr, Custom Mechanical Keyboard-F_Cu.gbr, Custom Mechanical Keyboard-F_Mask.gbr, Custom Mechanical Keyboard-F_Paste.gbr]
2025-10-16 Rewired rotary encoder, battery and row pins for space efficiency. Commit before export.
    [Custom Mechanical Keyboard.kicad_pcb, Custom Mechanical Keyboard.kicad_sch]
2025-10-20 Separated MCU and matrix boards, To be connected using FPC.
    [Custom Mechanical Keyboard (JLCPCB).csv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]
2025-10-22 Finished separate MCU and keyboard matrix boards, Added ribbon cable connectors and adjusted tracks to fit 0.05mm tolerance positioning. DRC checked, ready for export.
    [Custom Mechanical Keyboard (JLCPCB).csv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]
2025-10-24 Fixed DRC issues, shifted MCU side FPC connector to face opposite way (ribbon cable goes around and under MCU pcb).
    [Custom Mechanical Keyboard BOM (JLCPCB).csv, Custom Mechanical Keyboard BOM.csv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]
2025-10-25 feat: Added connection points between MCU and matrix pcb, and indicated v-cut point, generated export for JLCPCB.
    [Custom Mechanical Keyboard-B_Cu.gbl, Custom Mechanical Keyboard-B_Cu.gbr, Custom Mechanical Keyboard-B_Mask.gbr, Custom Mechanical Keyboard-B_Mask.gbs, Custom Mechanical Keyboard-B_Paste.gbp, Custom Mechanical Keyboard-B_Paste.gbr, Custom Mechanical Keyboard-B_Silkscreen.gbo, Custom Mechanical Keyboard-B_Silkscreen.gbr]
2025-10-26 fix: Made mouse bites instead of v-cut, commit before seperate pcb export.
    [Custom Mechanical Keyboard-B_Cu.gbl, Custom Mechanical Keyboard-B_Mask.gbs, Custom Mechanical Keyboard-B_Paste.gbp, Custom Mechanical Keyboard-B_Silkscreen.gbo, Custom Mechanical Keyboard-Edge_Cuts.gm1, Custom Mechanical Keyboard-F_Cu.gtl, Custom Mechanical Keyboard-F_Mask.gts, Custom Mechanical Keyboard-F_Paste.gtp]
2025-10-26 feat: Swapped capslock LED to bottom (same as LED matrix)
    [Custom Mechanical Keyboard-B_Cu.gbl, Custom Mechanical Keyboard-B_Mask.gbs, Custom Mechanical Keyboard-B_Paste.gbp, Custom Mechanical Keyboard-B_Silkscreen.gbo, Custom Mechanical Keyboard-Edge_Cuts.gm1, Custom Mechanical Keyboard-F_Cu.gtl, Custom Mechanical Keyboard-F_Mask.gts, Custom Mechanical Keyboard-F_Paste.gtp]
2025-11-03 Commit after exports
    [Custom Mechanical Keyboard BOM.csv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]
2025-11-09 Feat: Changed level shifter from TXS0101DBV to SN74LVC1T45DBV, footprint and wiring not changed.
    [Custom Mechanical Keyboard.kicad_pcb, Custom Mechanical Keyboard.kicad_sch]
2025-11-11 Feat: Added USB PCB, edited PCM Master Lib sunken usb-c port - changed pcb edge line to drawing to allow for edge cut line connection
    [Custom Mechanical Keyboard.kicad_pcb, Custom Mechanical Keyboard.kicad_sch]
2025-11-11 Fix: Changed USB C receptacle to 31M12 instead of 31M14 to fit cheaper assembly requirements
    [Custom Mechanical Keyboard BOM.csv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]
2025-11-11 Feat: Generated export for USB Plug
    [Custom Mechanical Keyboard BOM.csv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]
